Aecert-Robotics/Arduino-RC-Transmitter/Pics/rc on graph paper.png

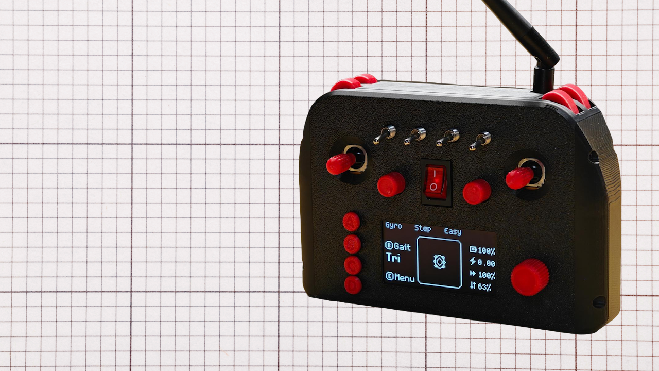
Pics/rc on graph paper.png
