Aecert-Robotics/Arduino-RC-Transmitter/README.md

# Arduino-RC-Transmitter
Arduino Mega Pro powered RC Transmitter using the NRF24L01+ chip
