Aecert-Robotics/Arduino-RC-Transmitter/Pics/1739720982140.jpg

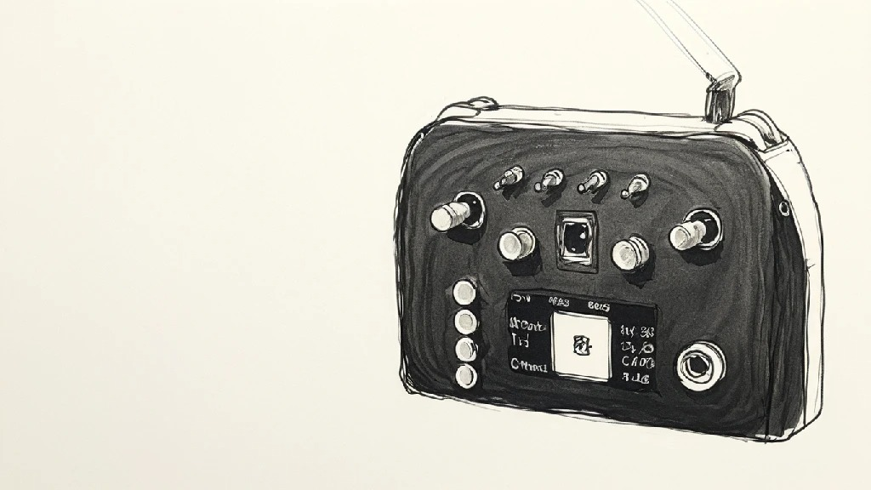
Pics/1739720982140.jpg
