Aecert-Robotics/Arduino-RC-Transmitter/Pics/cad pic bottom.png

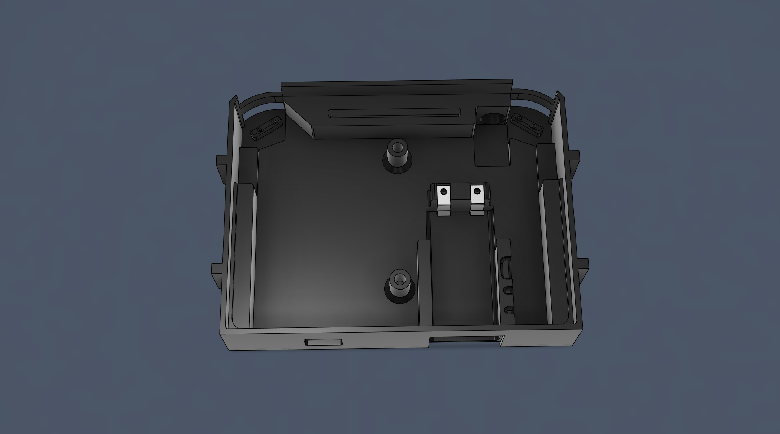
Pics/cad pic bottom.png
