Aecert-Robotics/Arduino-RC-Transmitter/Pics/cad pic f360.png

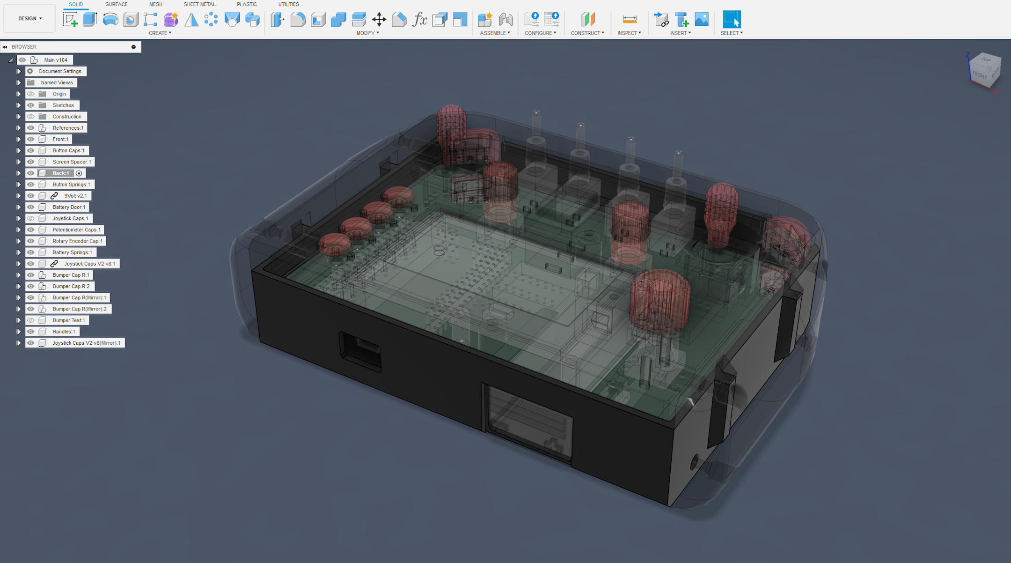
Pics/cad pic f360.png
