Aecert-Robotics/Arduino-RC-Transmitter/Pics/cad pic no top.png

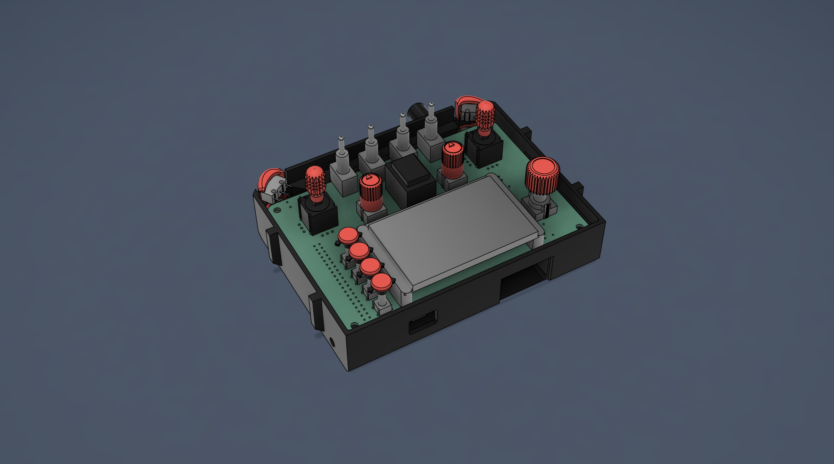
Pics/cad pic no top.png
