Aecert-Robotics/Arduino-RC-Transmitter/Pics/cad pic.png

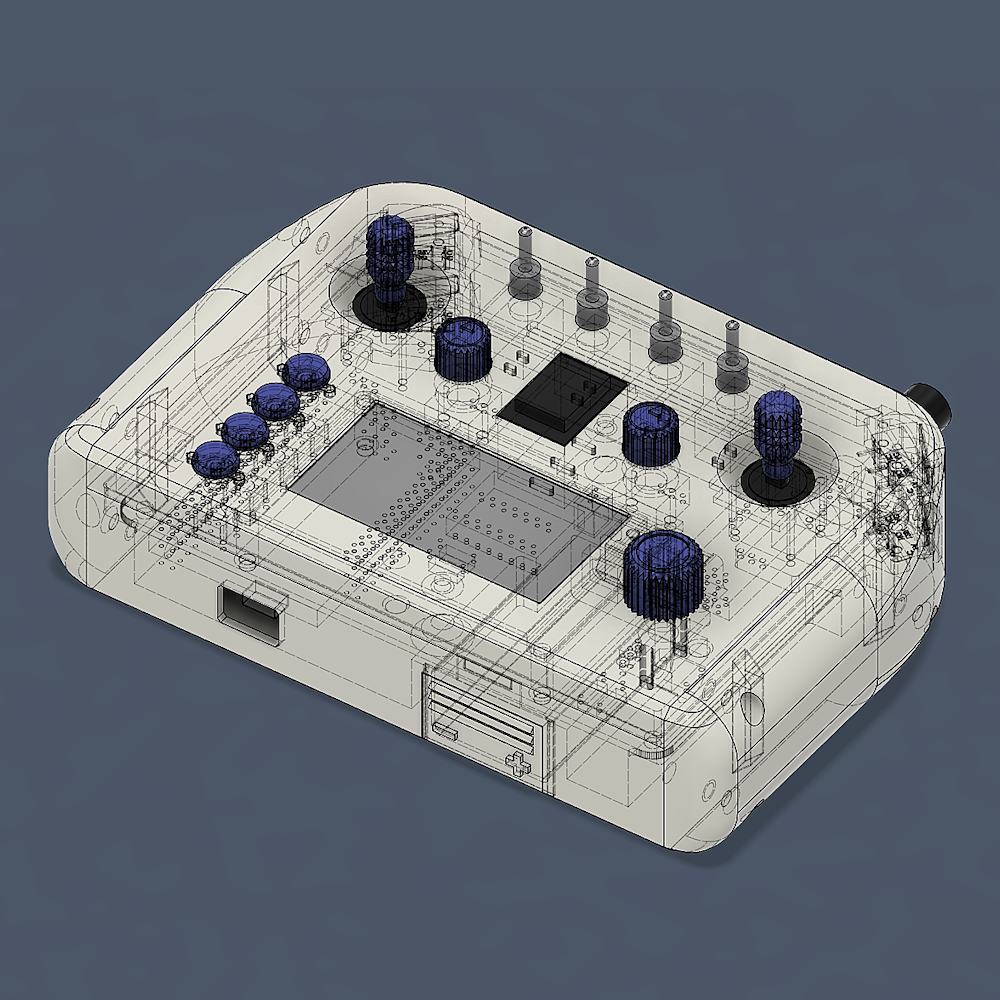
Pics/cad pic.png
