Aecert-Robotics/Arduino-RC-Transmitter/Pics/Color Combos/Black-Blue.png

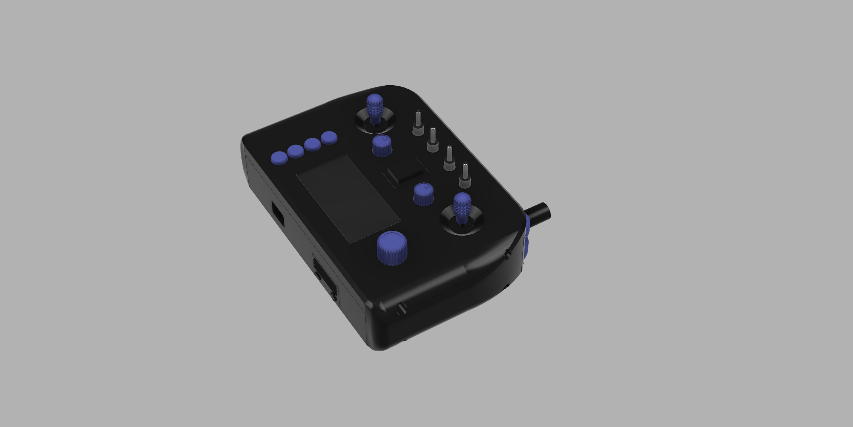
Pics/Color Combos/Black-Blue.png
