Aecert-Robotics/Arduino-RC-Transmitter/Pics/Color Combos/White-Black.png

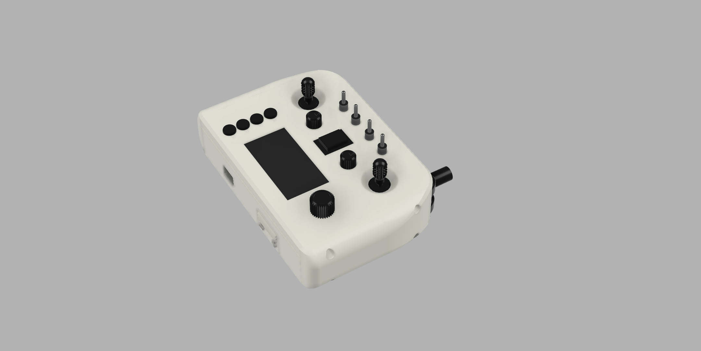
Pics/Color Combos/White-Black.png
