Aecert-Robotics/Arduino-RC-Transmitter/Pics/Finished Controller C.png

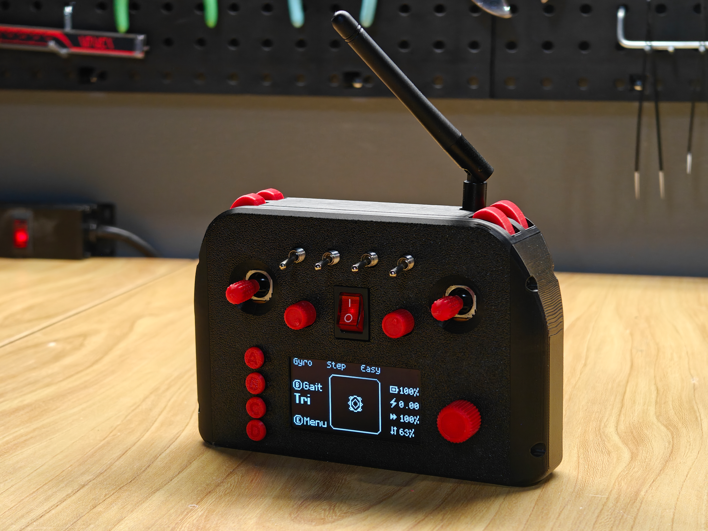
Pics/Finished Controller C.png
