Aecert-Robotics/Arduino-RC-Transmitter/Pics/Finished Controller.png

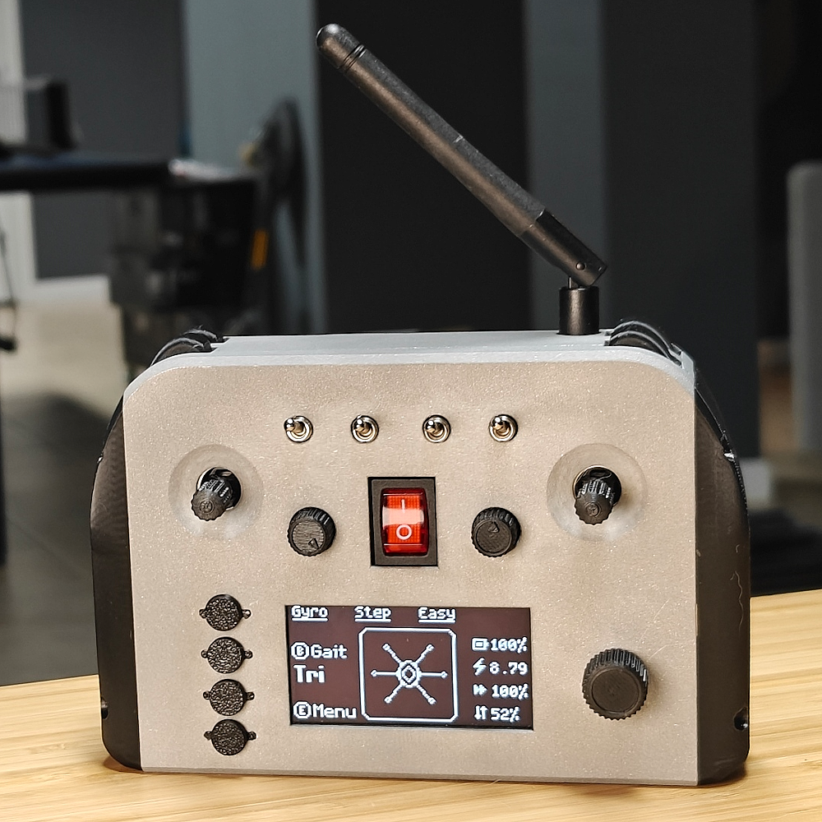
Pics/Finished Controller.png
