Aecert-Robotics/Arduino-RC-Transmitter/Pics/freepik_br_1479daa3-64c5-4ea8-824e-799db65ea386.png

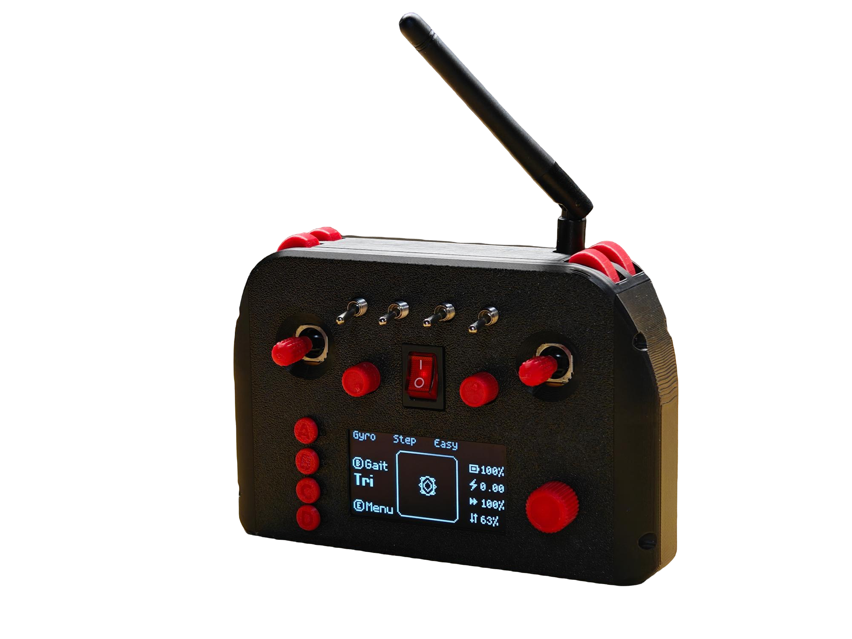
Pics/freepik_br_1479daa3-64c5-4ea8-824e-799db65ea386.png
