Aecert-Robotics/Arduino-RC-Transmitter/Pics/Inputs.jpg

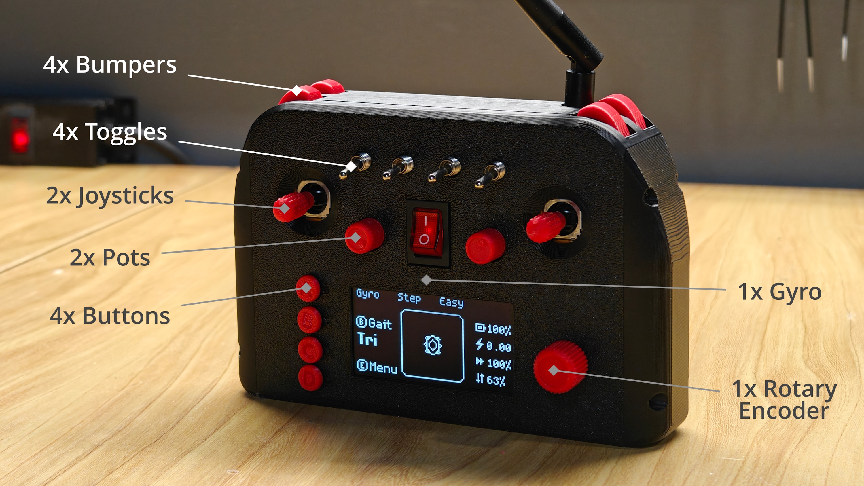
Pics/Inputs.jpg
