Aecert-Robotics/Arduino-RC-Transmitter/Pics/Kit in box.jpg

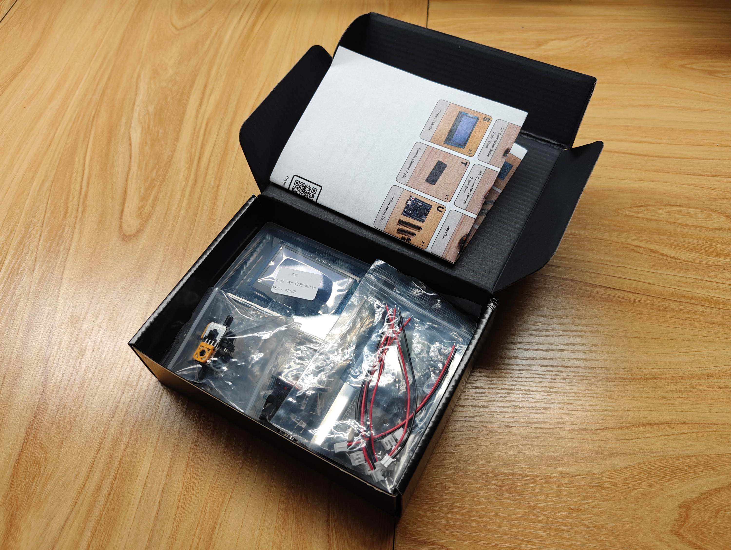
Pics/Kit in box.jpg
