Aecert-Robotics/Arduino-RC-Transmitter/Pics/Kit Opened V2.jpg

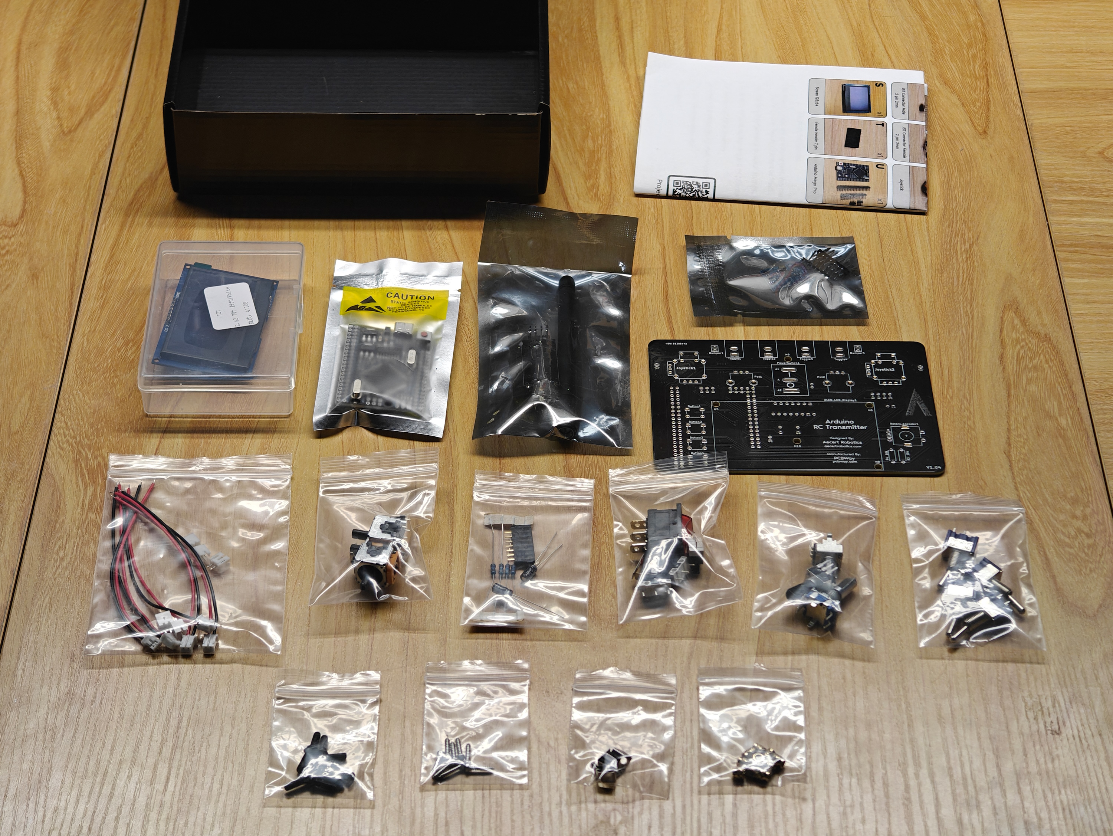
Pics/Kit Opened V2.jpg
