Aecert-Robotics/Arduino-RC-Transmitter/Pics/PCB V1.04.jpg

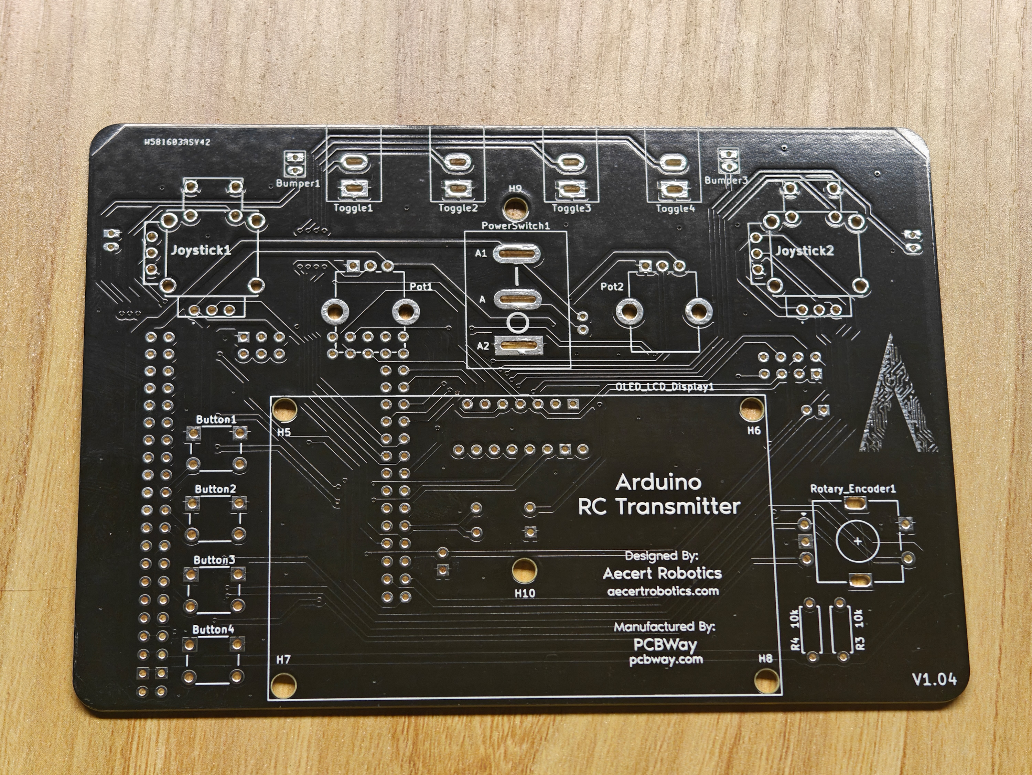
Pics/PCB V1.04.jpg
