Aecert-Robotics/Arduino-RC-Transmitter/Pics/rc white background.png

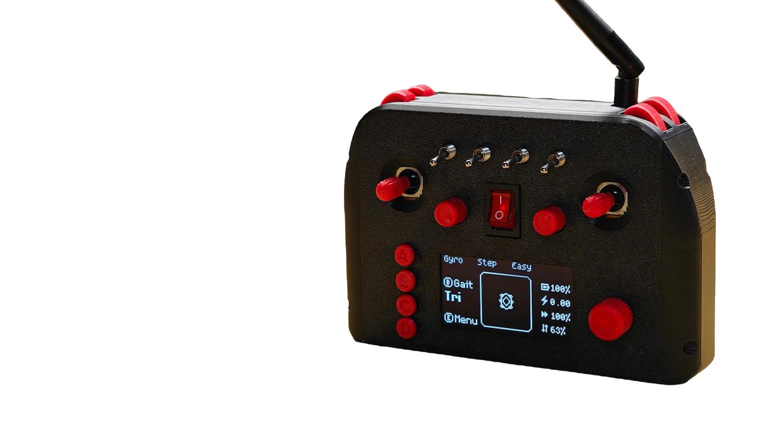
Pics/rc white background.png
