Aecert-Robotics/Arduino-RC-Transmitter/Pics/Wireframe transparent background.png

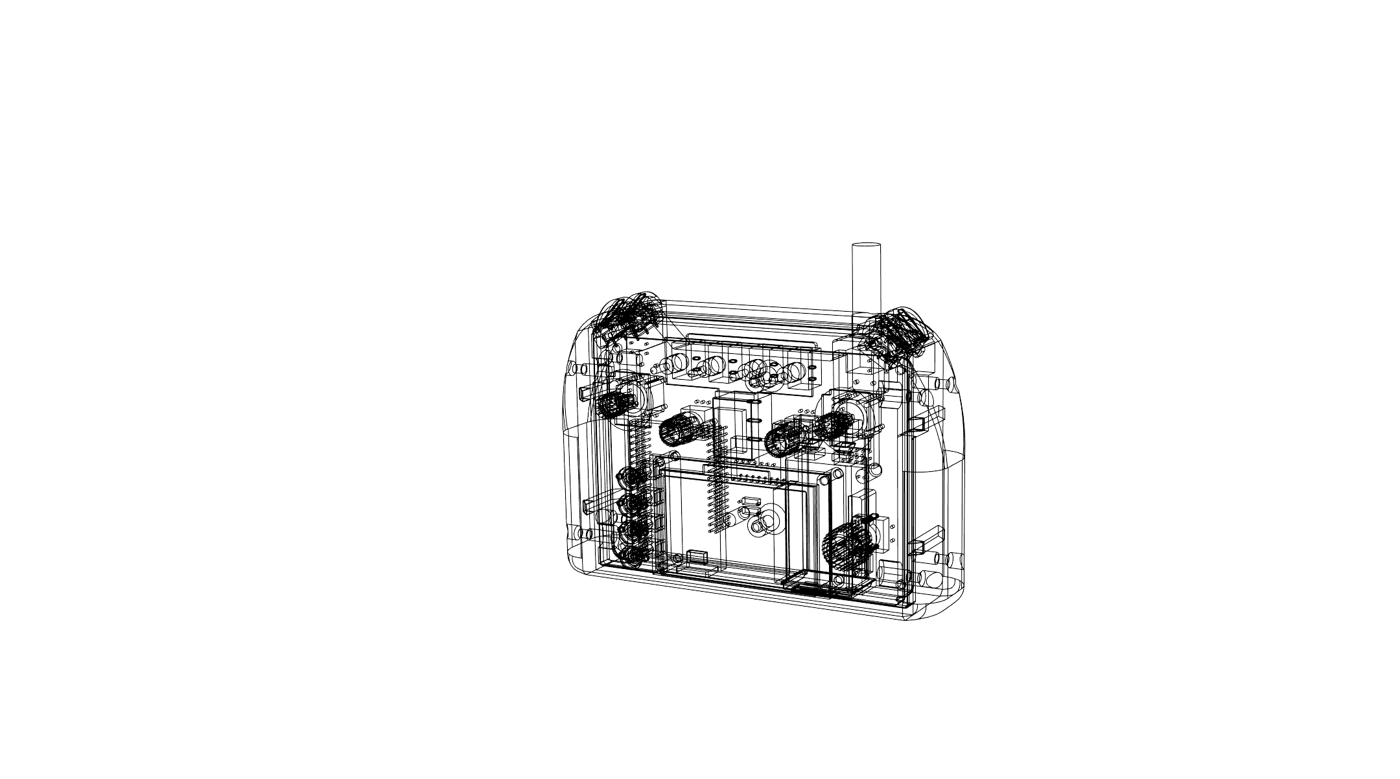
Pics/Wireframe transparent background.png
