Aecert-Robotics/Arduino-RC-Transmitter/Parts List and Instructions/Parts List and Instructions-3.png

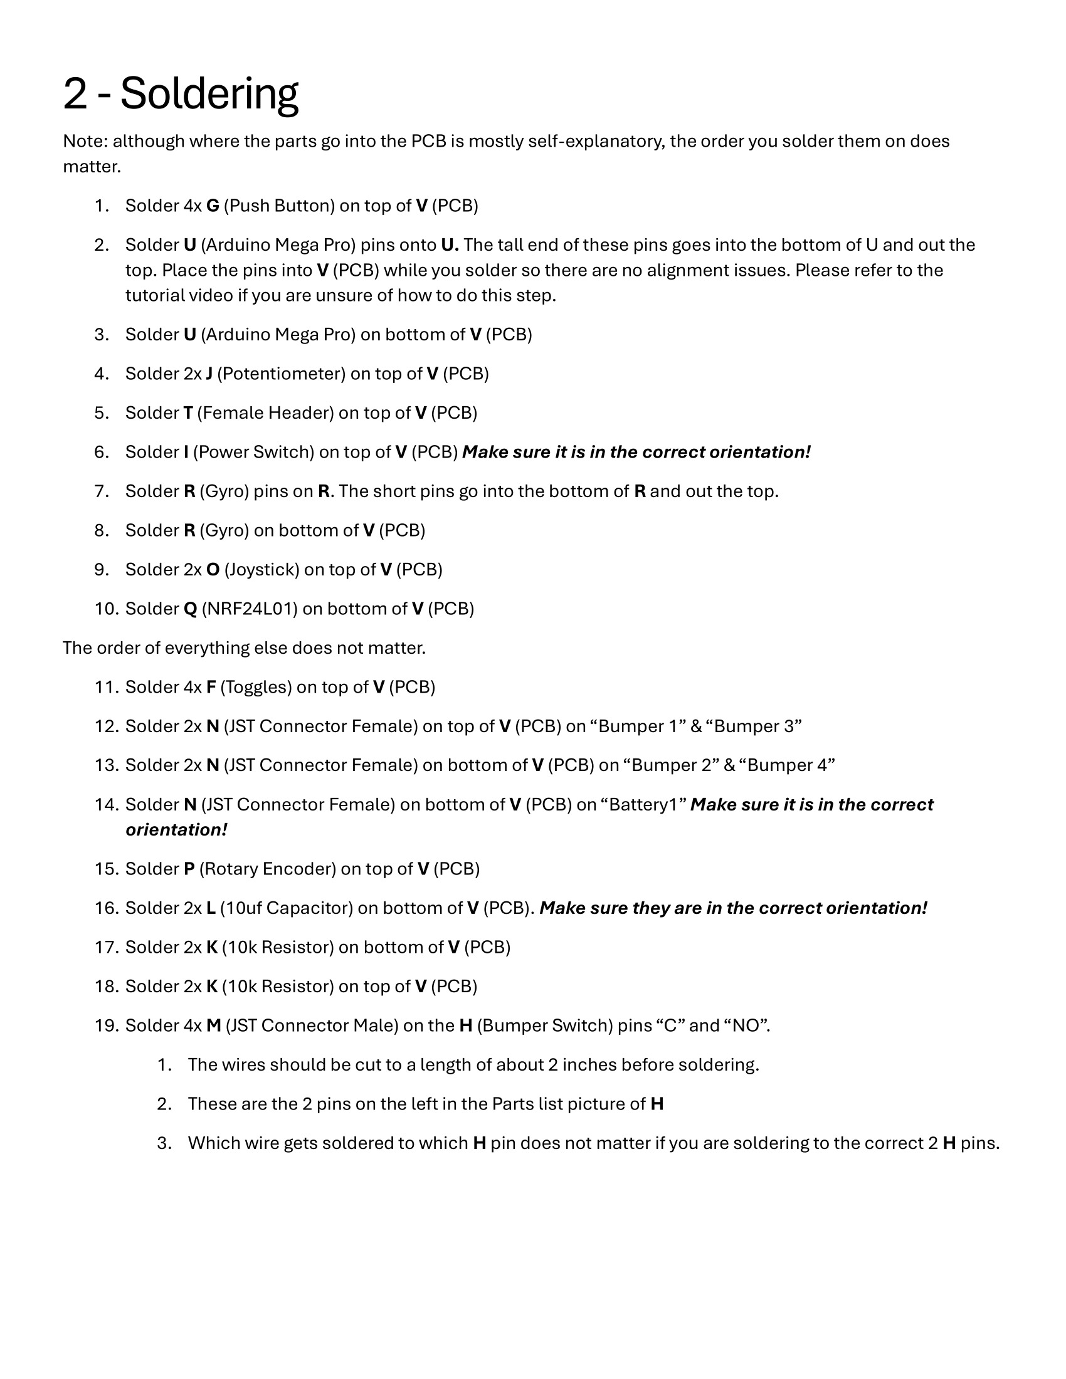
Parts List and Instructions/Parts List and Instructions-3.png
