Aecert-Robotics/Arduino-RC-Transmitter/PCB/PCB STEP.step

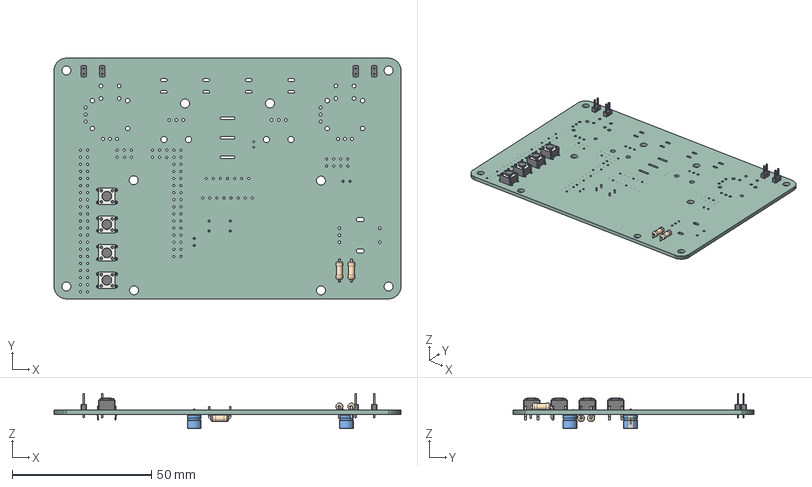
[picture p23: CAD file, 2024-11-24]
PCB/PCB STEP.step
124.5 x 86.4 x 12.7 mm
RCTransmitterAecertRobotics PCB
