Aecert-Robotics/Arduino-RC-Transmitter/STL's/Groups/Everything.3mf

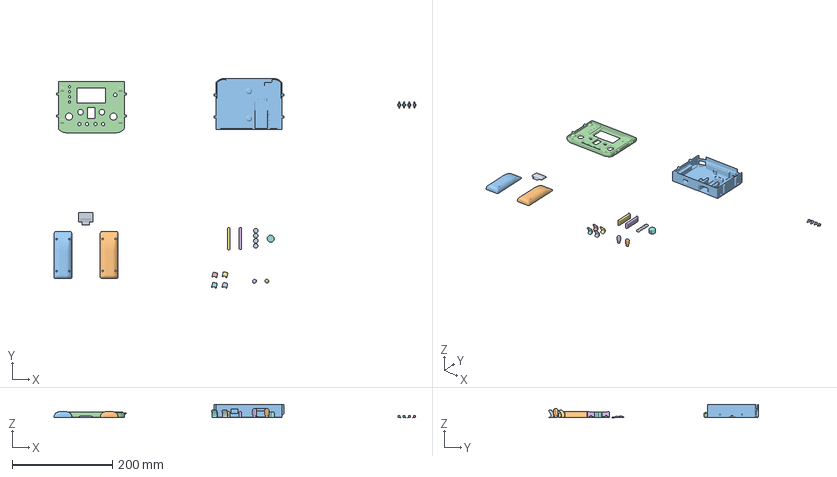
[picture p24: CAD file, 2025-02-27]
STL's/Groups/Everything.3mf
720.6 x 418.2 x 26.7 mm
Case Parts.stl_5
Case Parts.stl_6
Case Parts.stl_7
Case Parts.stl_8
Case Parts.stl_9
Cap Parts.stl_5
Cap Parts.stl_6
Cap Parts.stl_7
Button Caps.stl
Handle Left.stl
Handle Right.stl
Case Front.stl
Bumper Cap.stl x 4
Joystick Caps V2.stl x 2
Case Back.stl
