Aecert-Robotics/Arduino-RC-Transmitter/STL's/Joystick Caps V3.stl

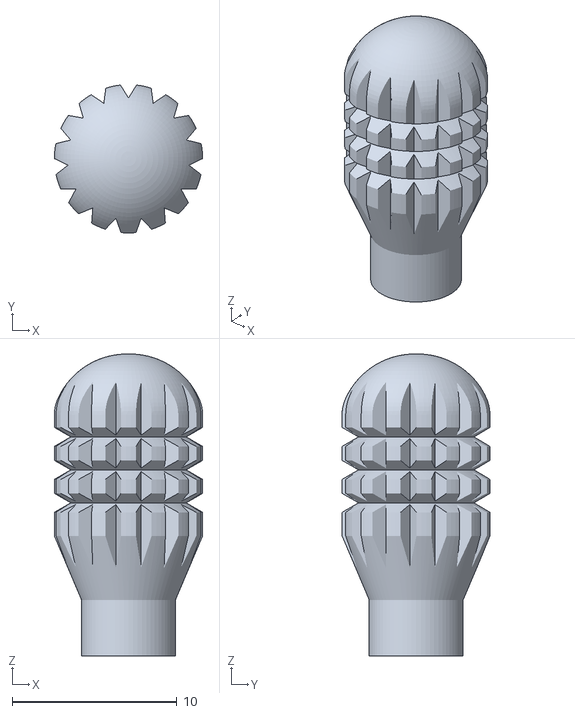
[picture p25: CAD file, 2025-04-06]
STL's/Joystick Caps V3.stl
9.00 x 8.97 x 18.3
