Aecert-Robotics/Arduino-RC-Transmitter/STL's/Button Cap if the springs dont work for you (Simple Electronics).stl

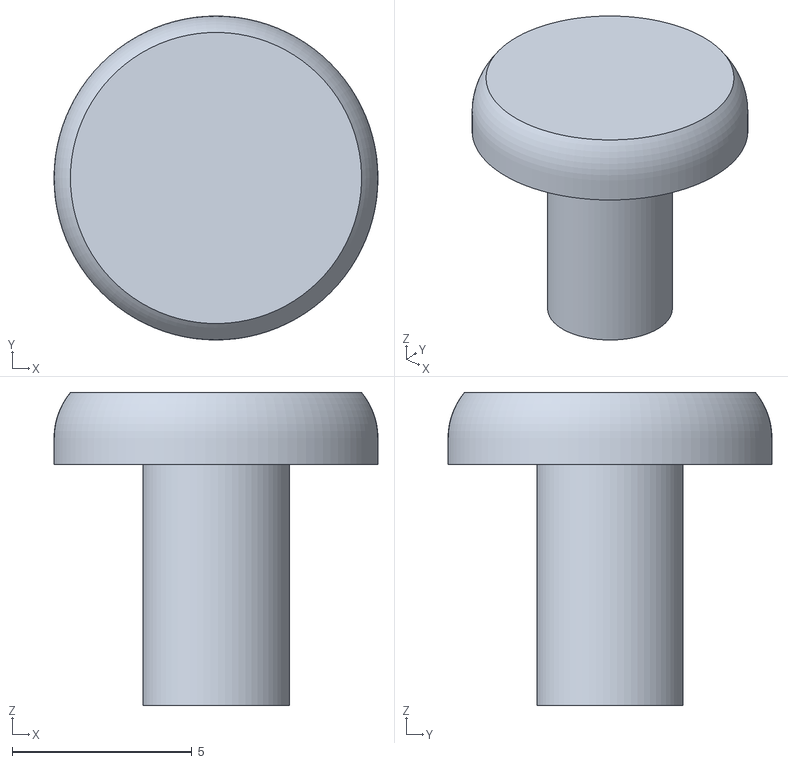
[picture p26: CAD file, 2025-03-11]
STL's/Button Cap if the springs dont work for you (Simple Electronics).stl
9.00 x 9.00 x 8.70
