Aecert-Robotics/Arduino-RC-Transmitter/STL's/Groups/Handles + Battery Door.stl

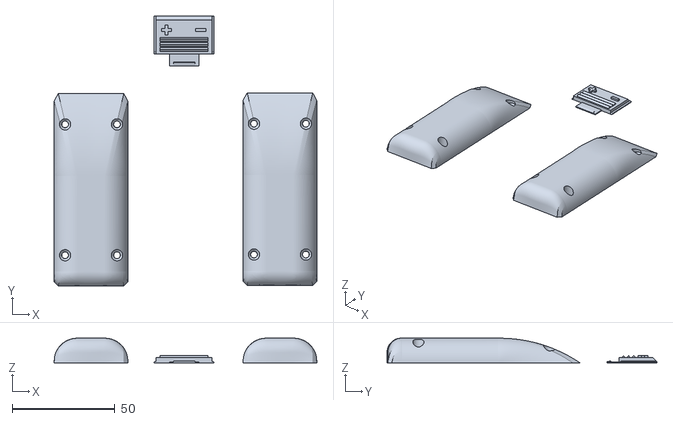
[picture p27: CAD file, 2025-02-26]
STL's/Groups/Handles + Battery Door.stl
127.9 x 131.5 x 12.0
