Aecert-Robotics/Arduino-RC-Transmitter/STL's/Groups/Case Back.stl

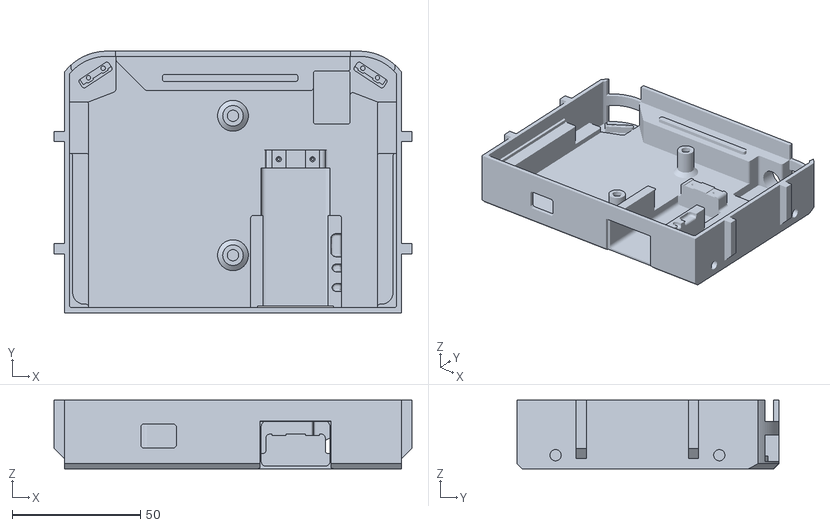
[picture p28: CAD file, 2025-02-15]
STL's/Groups/Case Back.stl
139.4 x 101.9 x 26.7
