Aecert-Robotics/Arduino-RC-Transmitter/STL's/Handles + Battery Door.stl

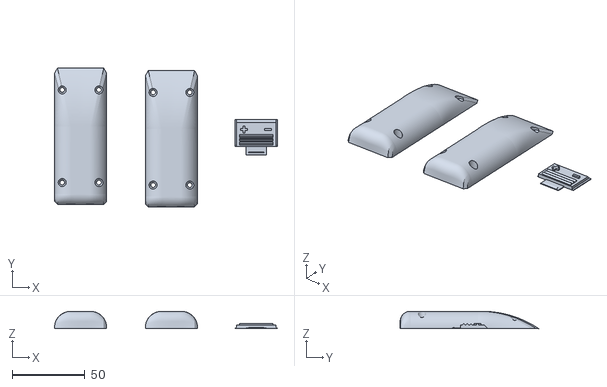
[picture p29: CAD file, 2025-02-15]
STL's/Handles + Battery Door.stl
153.4 x 95.4 x 12.0
