Aecert-Robotics/Arduino-RC-Transmitter/STL's/Groups/Case Front.stl

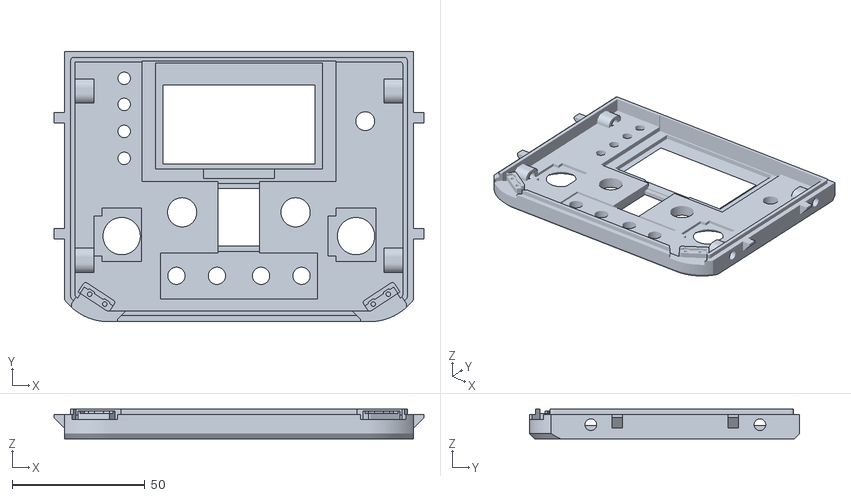
[picture p30: CAD file, 2025-02-15]
STL's/Groups/Case Front.stl
139.4 x 101.9 x 11.2
