Aecert-Robotics/Arduino-RC-Transmitter/STL's/Potentiometer Caps.stl

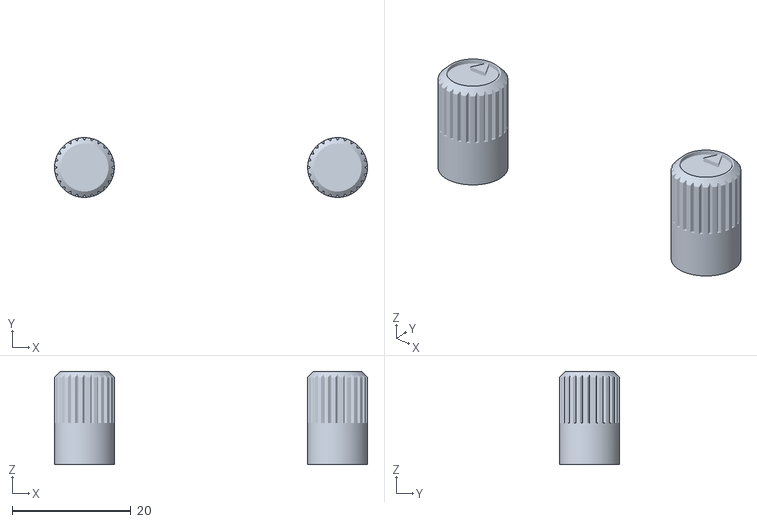
[picture p31: CAD file, 2025-01-16]
STL's/Potentiometer Caps.stl
52.8 x 10.1 x 15.8
