Aecert-Robotics/Arduino-RC-Transmitter/STL's/Groups/Button Springs.stl

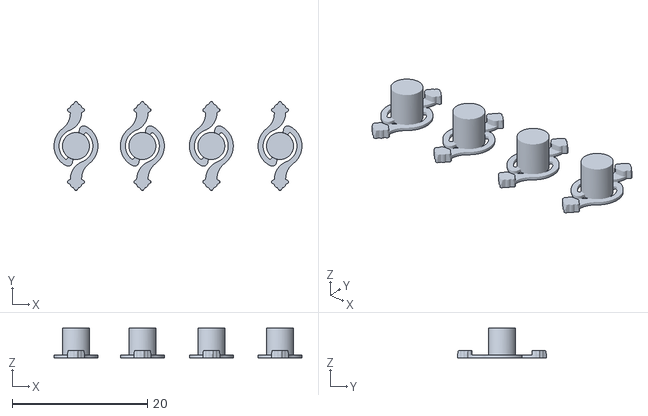
[picture p32: CAD file, 2025-02-04]
STL's/Groups/Button Springs.stl
36.7 x 13.1 x 4.40
