Aecert-Robotics/Arduino-RC-Transmitter/STL's/Handle Right.stl

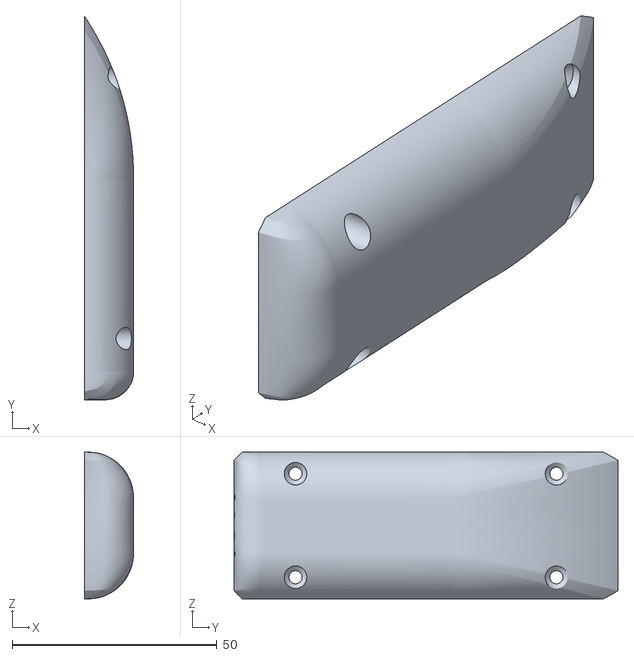
[picture p33: CAD file, 2024-12-10]
STL's/Handle Right.stl
12.0 x 93.7 x 35.9
