Aecert-Robotics/Arduino-RC-Transmitter/STL's/Button Caps.stl

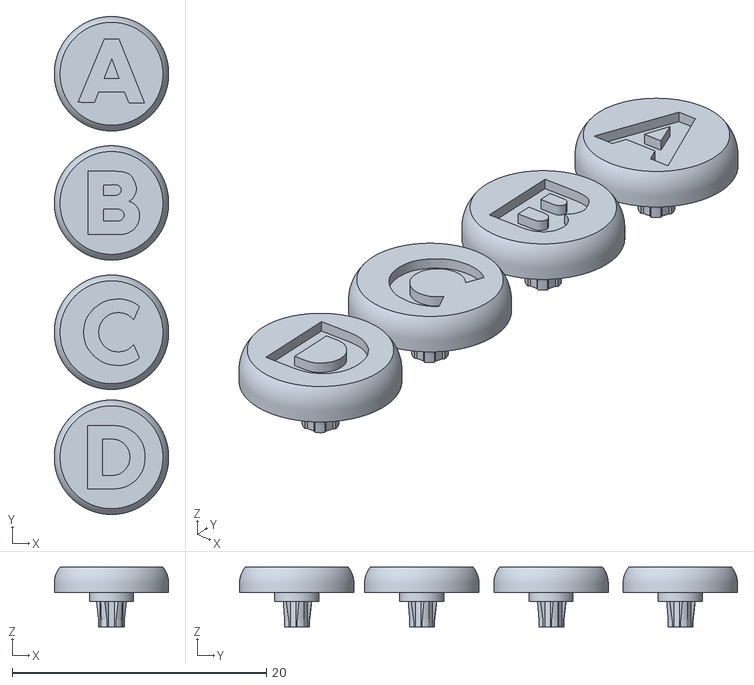
[picture p34: CAD file, 2024-11-30]
STL's/Button Caps.stl
9.00 x 39.1 x 4.70
