Aecert-Robotics/Arduino-RC-Transmitter/STL's/Bumper Cap.stl

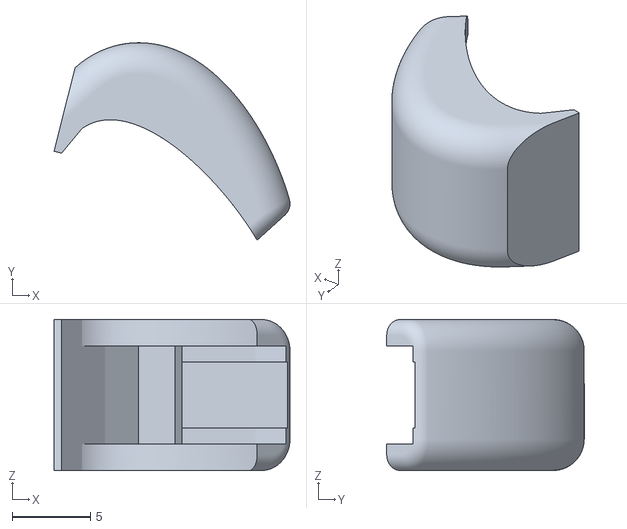
[picture p35: CAD file, 2024-11-28]
STL's/Bumper Cap.stl
15.1 x 12.6 x 9.65
