Aecert-Robotics/Arduino-RC-Transmitter/STL's/Screen Spacers.stl

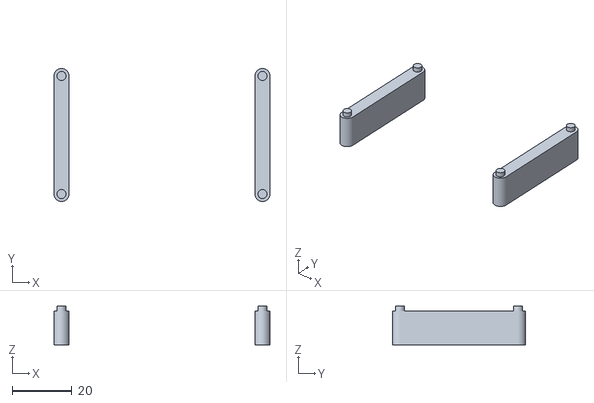
[picture p36: CAD file, 2024-11-24]
STL's/Screen Spacers.stl
72.0 x 44.4 x 12.9
