Aecert-Robotics/Arduino-RC-Transmitter/STL's/Battery Door.stl

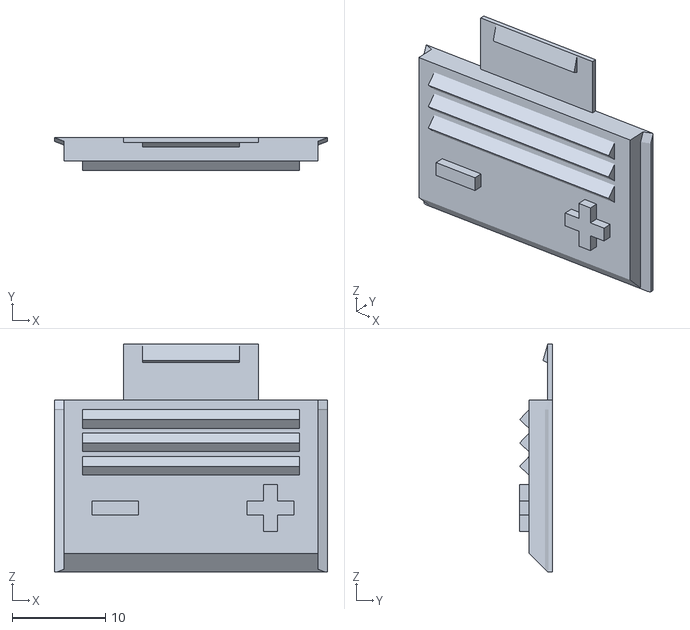
[picture p37: CAD file, 2024-11-24]
STL's/Battery Door.stl
29.2 x 3.50 x 24.4
