Aecert-Robotics/Arduino-RC-Transmitter/STL's/PCB (STEP).step

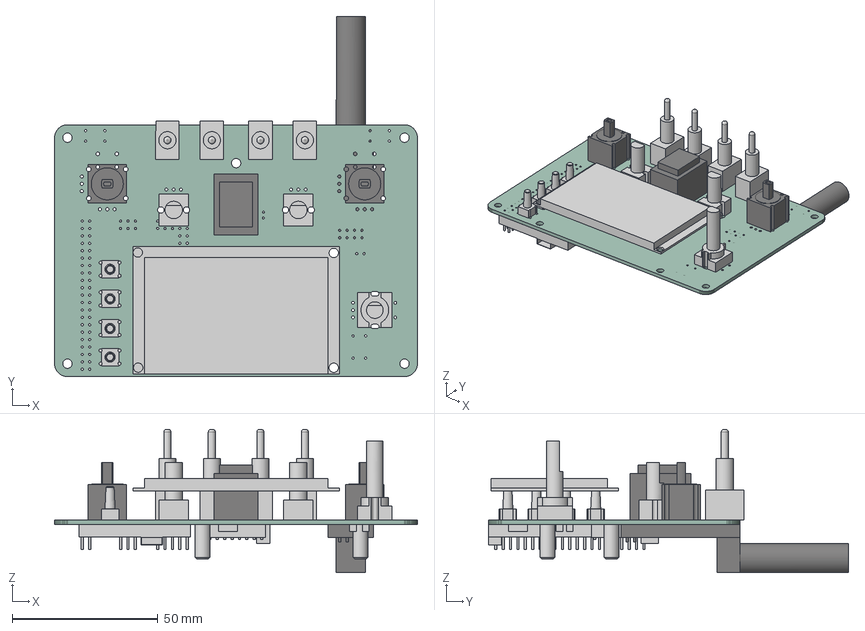
[picture p38: CAD file, 2024-11-24]
STL's/PCB (STEP).step
124.5 x 123.5 x 49.2 mm
PCB
Sketches
Buttons
Rotary Encoder
Joysticks
Potentiometers
Power Switch
Toggles
Screen
Arduino Mega
Capacitors
Resistors
MPU6050
JST Battery Connector
NRF24
