Aecert-Robotics/Arduino-RC-Transmitter/STL's/Rotary Encoder Cap.stl

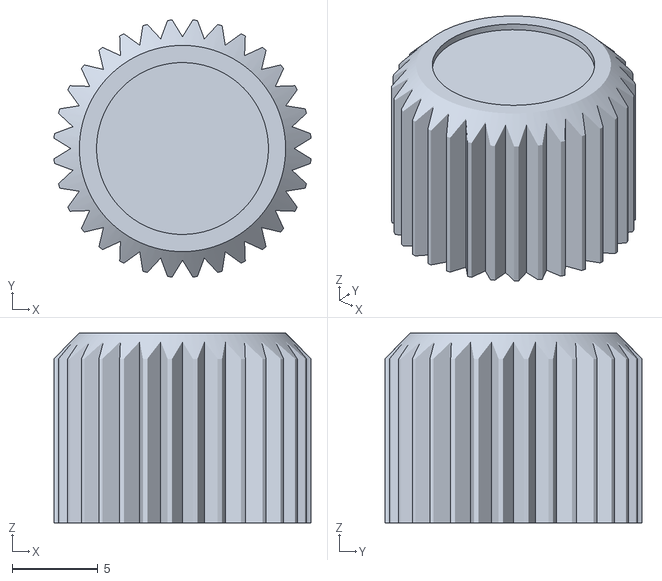
[picture p39: CAD file, 2024-11-24]
STL's/Rotary Encoder Cap.stl
15.0 x 15.0 x 11.1
