Aecert-Robotics/Arduino-RC-Transmitter/(list of files, cad)

Other CAD files:
STL's/Handle Left.stl
STL's/Button Springs.stl
STL's/Joystick Caps V2.stl
