Aecert-Robotics/Arduino-RC-Transmitter/PCB/RCTransmitterAecertRobotics.kicad_pcb

## KiCad design PCB/RCTransmitterAecertRobotics.kicad_pcb (2025-03-11)

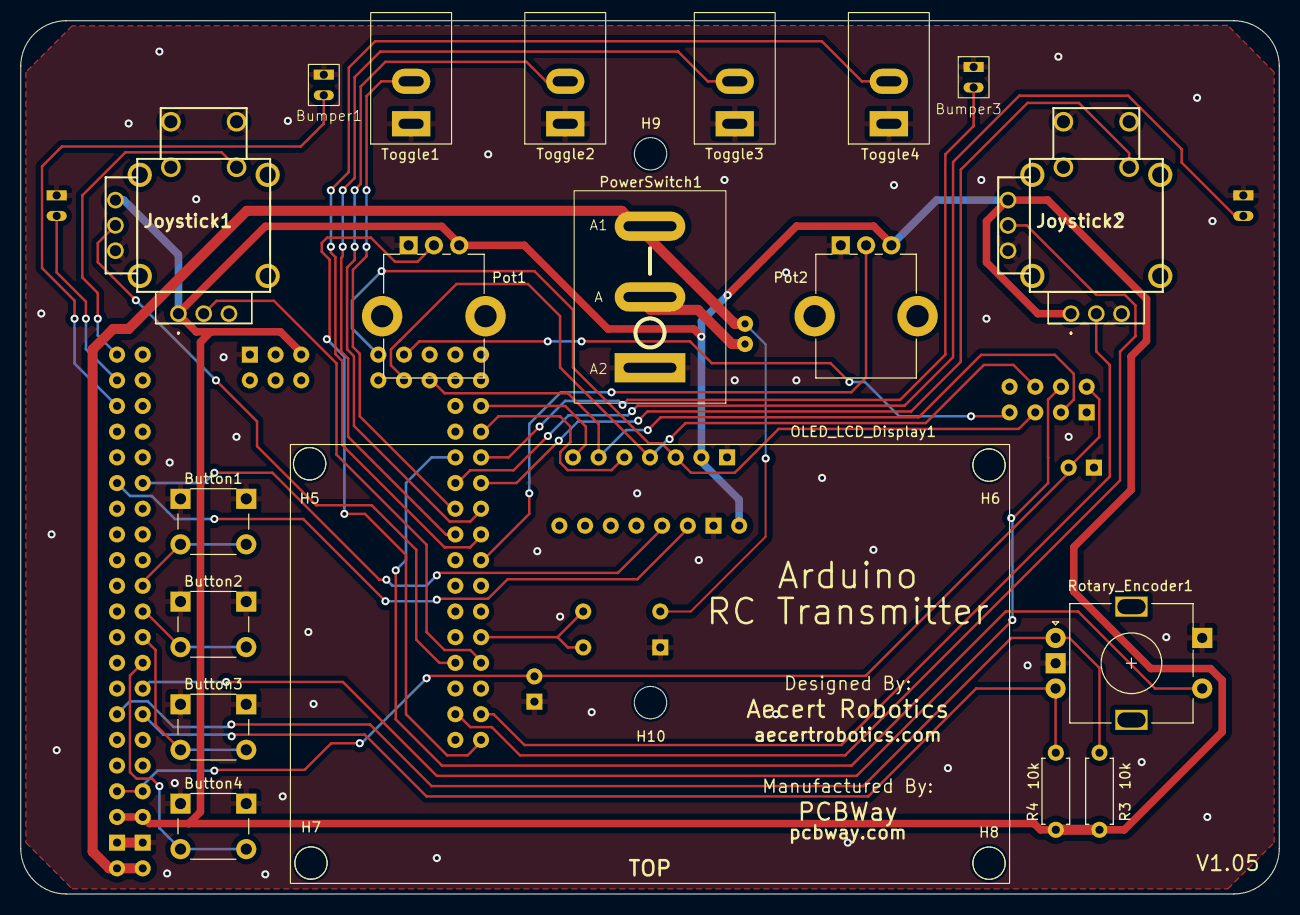
[picture p40: board RCTransmitterAecertRobotics.kicad_pcb from above]

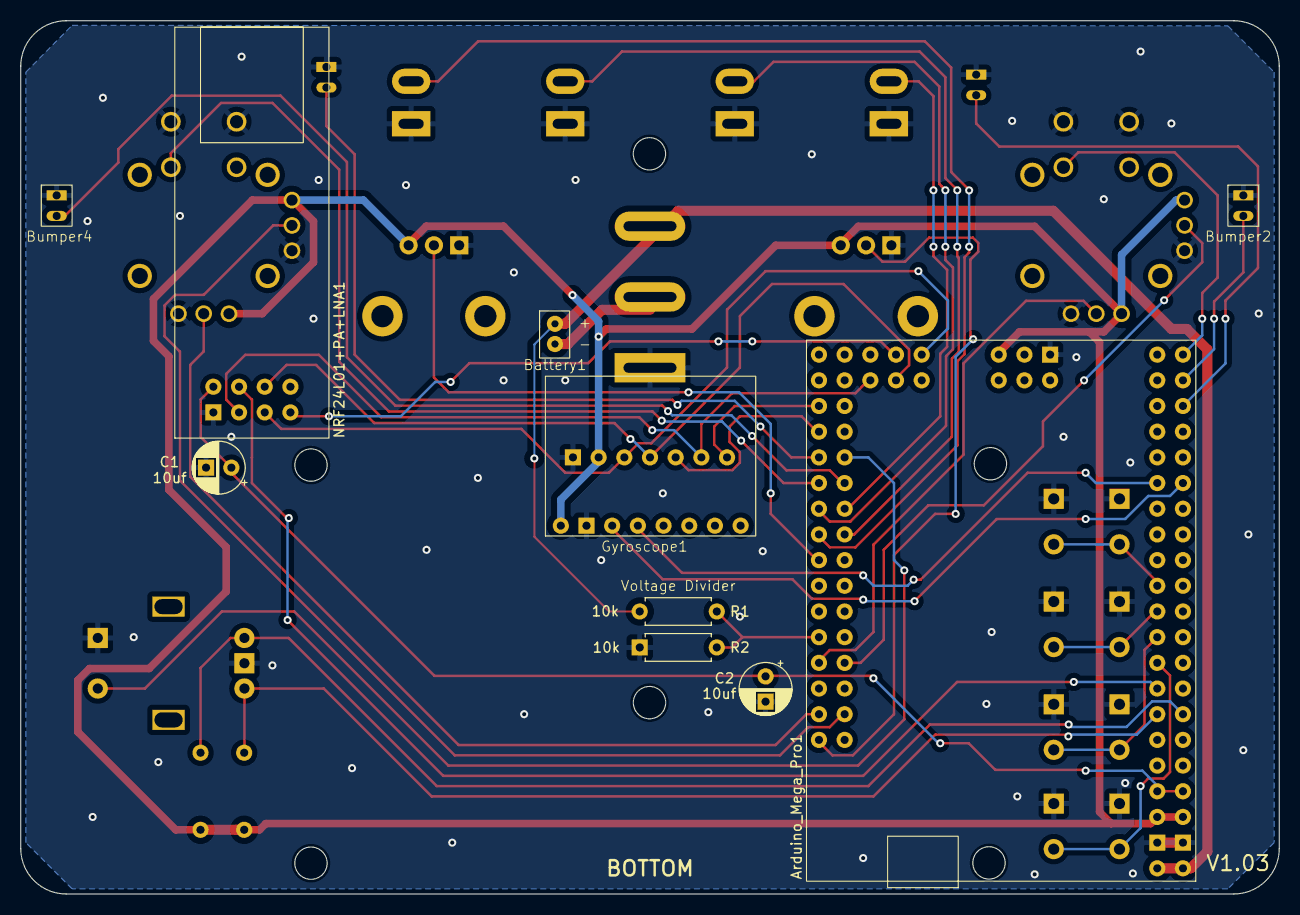
[picture p41: board RCTransmitterAecertRobotics.kicad_pcb from below]

Board: 2 copper layers, 124.5 x 86.4 mm, 35 parts (10 on the bottom side), 38 nets.

Parts:
Arduino_Mega_Pro1: Arduino Mega Pro Mini; Arduino Mega Pro
Battery1: 1.27mm_JST_Connector_1; JST Female Connector
Bumper1: SW_Push Left Bumper A; Bumper Pads
Bumper2: SW_Push Left Bumper B; Bumper Pads
Bumper3: SW_Push Right Bumper A; Bumper Pads
Bumper4: SW_Push Right Bumper B; Bumper Pads
Button1: SW_Push A; SW_PUSH_6mm
Button2: SW_Push B; SW_PUSH_6mm
Button3: SW_Push C; SW_PUSH_6mm
Button4: SW_Push D; SW_PUSH_6mm
C1, C2: 10uf; CP_Radial_D5.0mm_P2.50mm
Gyroscope1: MPU6050 Gyroscope
H5, H6, H7, H8, H9, H10: MountingHole_Pad; MountingHole_3.2mm_M3
Joystick1: THB001P Joy Left; THB001P
Joystick2: THB001P Joy Right; THB001P
NRF24L01+PA+LNA1: NRF24L01+PA+LNA1; NRF24L01+ Antenna
OLED_LCD_Display1: SSD1309 2.4inch; OLED LCD Display SSD1309
Pot1, Pot2: 10k; Potentiometer_Bourns_PTV09A-1_Single_Vertical
PowerSwitch1: KCD1 Power Switch; KCD1 Mini Rocker Switch
R1, R2, R3, R4: 10k; R_Axial_DIN0207_L6.3mm_D2.5mm_P7.62mm_Horizontal
Rotary_Encoder1: EC11E; RotaryEncoder_Alps_EC11E-Switch_Vertical_H20mm
Toggle1, Toggle2, Toggle3, Toggle4: SW_DIP_x01; SPST Mini Toggle Switch 2 Pin 2 Position

Connections:
/3.3v: Arduino_Mega_Pro1.3V3, C1.1, C2.1, NRF24L01+PA+LNA1.1 (V+)
/5v: Arduino_Mega_Pro1.5V, Gyroscope1.1 (VCC), Joystick1.1, Joystick1.11 (1'), Joystick2.1, Joystick2.11 (1'), OLED_LCD_Display1.6 (VCC), Pot1.3, Pot2.3, R3.1, R4.1
/Bat+: Arduino_Mega_Pro1.VIN, Battery1.1, PowerSwitch1.3 (Load), R1.2
/Bat-: Battery1.2, PowerSwitch1.2 (Power)
/Battery Voltage: Arduino_Mega_Pro1.A8, R1.1, R2.2
/Button A: Arduino_Mega_Pro1.12 (D12), Button1.2
/Button B: Arduino_Mega_Pro1.10 (D10), Button2.2
/Button C: Arduino_Mega_Pro1.8 (D8), Button3.2
/Button D: Arduino_Mega_Pro1.6 (D6), Button4.2
/CE: Arduino_Mega_Pro1.49 (D49), NRF24L01+PA+LNA1.7 (CE), OLED_LCD_Display1.2 (DC)
/Joy Left Button: Arduino_Mega_Pro1.31 (D31), Joystick1.A1 (COM_1)
/Joy Left X: Arduino_Mega_Pro1.A6, Joystick1.2
/Joy Left Y: Arduino_Mega_Pro1.A7, Joystick1.12 (2')
/Joy Right Button: Arduino_Mega_Pro1.36 (D36), Joystick2.A1 (COM_1)
/Joy Right X: Arduino_Mega_Pro1.A2, Joystick2.2
/Joy Right Y: Arduino_Mega_Pro1.A3, Joystick2.12 (2')
/Left Bumper A: Arduino_Mega_Pro1.27 (D27), Bumper1.2
/Left Bumper B: Arduino_Mega_Pro1.29 (D29), Bumper2.2
/MISO: Arduino_Mega_Pro1.50 (D50(MISO)), NRF24L01+PA+LNA1.5 (MISO)
/MOSI: Arduino_Mega_Pro1.51 (D51(MOSI)), NRF24L01+PA+LNA1.3 (MOSI), OLED_LCD_Display1.4 (SDA)
/NRF CSN: Arduino_Mega_Pro1.4 (D4), NRF24L01+PA+LNA1.2 (CSN)
/Pot Left: Arduino_Mega_Pro1.A0, Pot1.2
/Pot Right: Arduino_Mega_Pro1.A14, Pot2.2
/Right Bumper A: Arduino_Mega_Pro1.38 (D38), Bumper3.2
/Right Bumper B: Arduino_Mega_Pro1.37 (D37), Bumper4.2
/Rotary Encoder Switch: Arduino_Mega_Pro1.39 (D39), Rotary_Encoder1.S1
/RotaryEncoderA: Arduino_Mega_Pro1.2 (D2), R4.2, Rotary_Encoder1.B
/RotaryEncoderB: Arduino_Mega_Pro1.3 (D3), R3.2, Rotary_Encoder1.A
/SCK: Arduino_Mega_Pro1.52 (D52(SCLK)), NRF24L01+PA+LNA1.6 (SCK), OLED_LCD_Display1.5 (SCK)
/SCL: Arduino_Mega_Pro1.21 (D21(SCL)), Gyroscope1.3 (SCL)
/SDA: Arduino_Mega_Pro1.20 (D20(SDA)), Gyroscope1.4 (SDA)
/Screen CS: Arduino_Mega_Pro1.42 (D42), OLED_LCD_Display1.1 (CS)
/Screen RES: Arduino_Mega_Pro1.40 (D40), OLED_LCD_Display1.3 (RES)
/Toggle A: Arduino_Mega_Pro1.35 (D35), Toggle1.2
/Toggle B: Arduino_Mega_Pro1.34 (D34), Toggle2.2
/Toggle C: Arduino_Mega_Pro1.33 (D33), Toggle3.2
/Toggle D: Arduino_Mega_Pro1.32 (D32), Toggle4.2
GND: Arduino_Mega_Pro1.GND, Bumper1.1, Bumper2.1, Bumper3.1, Bumper4.1, Button1.1, Button2.1, Button3.1, Button4.1, C1.2, C2.2, Gyroscope1.2 (GND), Joystick1.3, Joystick1.13 (3'), Joystick1.C1 (NO_1), Joystick1.D1 (NO_2), Joystick2.3, Joystick2.13 (3'), Joystick2.C1 (NO_1), Joystick2.D1 (NO_2), NRF24L01+PA+LNA1.8 (GND), OLED_LCD_Display1.7 (GND), Pot1.1, Pot2.1, PowerSwitch1.1 (LED), R2.1, Rotary_Encoder1.C, Rotary_Encoder1.S2, Toggle1.1, Toggle2.1, Toggle3.1, Toggle4.1
