Aecert-Robotics/Arduino-RC-Transmitter/Code/Code-Simple/src/Globals.cpp

#include <Arduino.h>
#include "Globals.h"
#include "Helpers.h"
#include "Page.h"
#include <EEPROM.h>
#include "NRF.h"

HomePage *homePage = new HomePage();
MainMenuPage *mainMenuPage = new MainMenuPage();
ControlsPage *controlsPage = new ControlsPage();
SettingsPage *settingsPage = new SettingsPage();

Page *previousPage = nullptr;
Page *currentPage = homePage;

void loadValues()
{
    // Load NRF Address
    for (int i = 0; i < EEPROM_NRF_ADDRESS_ARRAY_SIZE; i++) {
        nrfAddress[i] = EEPROM.read(EEPROM_NRF_ADDRESS_ADDR + i);
    }

    booleanTest = EEPROM.read(EEPROM_BOOLEAN_TEST_ADDR);
    EEPROM.get(EEPROM_NUMBER_TEST_ADDR, numberTest); // Use EEPROM.get to read the long int value
}

void saveValues(){
    // Save NRF Address (array of bytes)
    bool addressChanged = false;
    for (int i = 0; i < EEPROM_NRF_ADDRESS_ARRAY_SIZE; i++) {
        if (EEPROM.read(EEPROM_NRF_ADDRESS_ADDR + i) != nrfAddress[i]) {
            addressChanged = true;
            break;
        }
    }
    if (addressChanged) {
        for (int i = 0; i < EEPROM_NRF_ADDRESS_ARRAY_SIZE; i++) {
            EEPROM.update(EEPROM_NRF_ADDRESS_ADDR + i, nrfAddress[i]);
        }
        setupNRF();
    }

    // Save boolean test (boolean, 1 byte)
    EEPROM.update(EEPROM_BOOLEAN_TEST_ADDR, booleanTest);

    // Save number test (long int, 4 bytes)
    EEPROM.put(EEPROM_NUMBER_TEST_ADDR, numberTest);
}
