Aecert-Robotics/Arduino-RC-Transmitter/(commit log)

2024-11-24 updated pcb
    [PCB STEP.step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]
2024-11-24 pcb update
    [RCTransmitterAecertRobotics.kicad_pcb]
2024-11-24 updated pcb, created gerber
    [RCTransmitterAecertRobotics-B_Cu.gbr, RCTransmitterAecertRobotics-B_Mask.gbr, RCTransmitterAecertRobotics-B_Paste.gbr, RCTransmitterAecertRobotics-B_Silkscreen.gbr, RCTransmitterAecertRobotics-Edge_Cuts.gbr, RCTransmitterAecertRobotics-F_Cu.gbr, RCTransmitterAecertRobotics-F_Mask.gbr, RCTransmitterAecertRobotics-F_Paste.gbr]
2024-11-28 added springs to case plate
    [Everything.3mf]
2024-12-03 stl updates
    [Case Back.stl, Case Parts.stl, Everything.3mf]
2024-12-10 fixes to fit the new parts
    [Case Back.stl, Case Front.stl, Case Parts.stl, Everything.3mf, Handle Left.stl, Handle Right.stl]
2025-01-06 Refactored code to fix a bug related to rotary encoder pressing
    [Case Front.stl, Case Parts.stl, Everything.3mf]
2025-01-16 Simple Transmitter + Receiver code
    [Everything.3mf, Potentiometer Caps.stl]
2025-02-04 updated STL groups
    [Button Springs.stl, Case Parts.stl, Everything.3mf]
2025-02-10 Updated PCB to fix bumper plug clearance
    [RCTransmitterAecertRobotics-B_Cu.gbr, RCTransmitterAecertRobotics-B_Mask.gbr, RCTransmitterAecertRobotics-B_Paste.gbr, RCTransmitterAecertRobotics-B_Silkscreen.gbr, RCTransmitterAecertRobotics-Edge_Cuts.gbr, RCTransmitterAecertRobotics-F_Cu.gbr, RCTransmitterAecertRobotics-F_Mask.gbr, RCTransmitterAecertRobotics-F_Paste.gbr]
2025-02-10 updated kicad project
    [RCTransmitterAecertRobotics.kicad_pcb, RCTransmitterAecertRobotics.kicad_sch]
2025-02-15 updated case bottom
    [Case Back.stl, Case Front.stl, Everything.3mf, Handles + Battery Door.stl]
2025-02-21 added a battery percentage display using the data from the voltage divider
2025-02-26 stl groups
    [Case Back.stl, Case Front.stl, Case Parts.stl, Handles + Battery Door.stl]
2025-02-27 plate names
    [Everything.3mf]
2025-03-11 code no longer freezes if gyro doesnt work.
    [RCTransmitterAecertRobotics.kicad_pcb]
2025-03-11 setup printing
2025-03-11 debug prints
2025-03-11 Create Button Cap if the springs dont work for you (Simple Electronics).stl
    [Button Cap if the springs dont work for you (Simple Electronics).stl]
2025-04-06 reworked joystick caps to not require glue
    [Joystick Caps V3.stl]
2025-04-21 added gyro data to data package and gyro mode to homepage
2025-04-22 gyro data fixed.
    the mpu5060_light library that i use has a -30 - 30 degree limit. i now enforce that.
    [HomePage.cpp, Inputs.cpp, main.cpp]
